srobo-legacy/boards-power-v4-hw/pbv4b_bom.xls

Line No. | Internal Part No. | Qty | Value/Description | Package | Distributor | Distributor Order No. | Manufacturer | Part No. | Reference Designators
1 | sr-c-100n-0402-16v | 35 | 100n capacitor 0402 16V X7R | 0402 | farnell | 1758896 | any/open |  | C4, C5, C8, C12, C15, C17, C24, C25, C27, C28, C29, C31, C32, C33, C34, C35, C37, C38, C39, C40, C41, C43, C44, C47, C48, C49, C50, C51, C52, C54, C56, C57, C58, C62, C63
2 | sr-c-100n-0603-50v | 2 | 100n capacitor 0603 50V X7R | 0603 | farnell | 1759122 | any/open |  | C1, C59
3 | sr-c-10n-0402-25v | 3 | 10n capacitor 0402 25V X7R | 0402 | farnell | 1758924 | any/open |  | C22, C45, C46
4 | sr-c-10p-0402-50v | 1 | 10p capacitor 0402 50V C0G/NP0 | 0402 | farnell | 1856064 | any/open |  | C19
5 | sr-c-10u-1206-16v | 8 | 10u capacitor 1206 16V X7R | 1206 | farnell | 2070502 | any/open |  | C3, C7, C13, C14, C26, C30, C36, C42
6 | sr-c-1u-0402-10v | 3 | 1u capacitor 0402 10V X5R | 0402 | farnell | 1759381 | any/open |  | C6, C23, C55
7 | sr-c-22u-0805-10v | 7 | 22u capacitor 0805 10V X5R | 0805 | farnell | 1867956 | any/open |  | C9, C10, C16, C18, C20, C21, C53
8 | sr-c-27p-0402-50v | 2 | 27p capacitor 0402 50V C0G/NP0 | 0402 | farnell | 1414584 | any/open |  | C60, C61
9 | sr-c-ucw1e471mnl1gs | 1 | 470u capacitor smt electrolytic 25V 850mA ripple | smt_electrolytic_cap | farnell | 1580575 | nichicon | UCW1E471MNL1GS | C2
10 | sr-cn-7460305 | 3 | M5 bushing 8 pin 2 row | press_fit | wurth | 7460305 | wurth elektronik | 7460305 | J1, J2, J3
11 | sr-cn-camcon2w | 6 | Pluggable terminal block 2way 7.5mm pitch male horiz | through_hole | farnell | 3882391 | camdenboss | CTB9550/2 | J8, J9, J10, J11, J12, J13
12 | sr-cn-camcon2w-5mm | 1 | Pluggable terminal block 2way 5mm pitch male horiz | through_hole | farnell | 3882093 | camdenboss | CTB9350/2A | J4
13 | sr-cn-header2x5-1.27mm | 1 | 2x5 through-hole 1.27mm header 3mm pin length | through_hole | farnell | 1577743 | any/open |  | J17
14 | sr-cn-header6 | 1 | 6Way header 1 row header | tht | farnell | 1593415 | any/open |  | J14
15 | sr-cn-minicamcon2w | 3 | Pluggable terminal block 2way 3.81mm pitch male horiz | through_hole | farnell | 1717071 | camdenboss | CTB93HE/2 | J6, J7, J15
16 | sr-cn-usb-micro-b | 1 | Micro USB B connector for top mounting | through_hole | digikey | 609-4048-6-ND | fci | 10103592-0001LF | J16
17 | sr-d-bat754c | 1 | schottky diode dual | sot23 | farnell | 1081205 | nxp | BAT754C | D13
18 | sr-d-bzx384c3v3 | 1 | zener diode 3.3V 5% | sod323 | farnell | 8735646 | nxp | BZX384-C3V3 | D4
19 | sr-d-mmbz15val | 3 | 12V unidirectional dual TVS diode 40W common anode | sot23 | farnell | 1829193 | nxp | MMBZ15VAL | D3, D14, D15
20 | sr-d-mmsz4689t1g | 1 | zener diode 5.1V 500mW | sod123 | farnell | 1459121 | on semiconductor | MMSZ4689T1G | D6
21 | sr-d-pesd5z12 | 9 | 12V unidirectional TVS diode 200W | sod523 | farnell | 1829227 | nxp | PESD5Z12 | D2, D7, D8, D9, D10, D11, D12, D16, D17
22 | sr-d-smaj15ca | 1 | 15V bidirectional TVS diode 400W | do-214ac(sma) | farnell | 9802789 | stmicroelectronics | SMAJ15CA-TR | D1
23 | sr-d-smaj5.0a | 1 | 5V unidirectional TVS diode 400W | do-214ac(sma) | farnell | 1815679 | vishay | SMAJ5.0A-E3/5A | D5
24 | sr-fan-40-10-12v | 1 | 40mmx40mmx10mm axial fan 12V | wire_ended | farnell | 1924856 | any/open |  | X2
25 | sr-fb-200m-1k-0402 | 1 | 200mA 1k @ 100MHz 0402 | 0402 | farnell | 1669673 | tdk | MMZ1005Y102C | L3
26 | sr-fet-n-bsh121 | 3 | BSH121 n-channel mosfet very low Vt of 1V | sot323 | farnell | 1758072 | nxp | BSH121 | Q3, Q4, Q5
27 | sr-fet-n-irfh5301 | 2 | IRFH5301PBF n-channel mosfet 35A | pqfn8 | farnell | 1782047 | international rectifier | IRFH5301TR2PBF | Q1, Q2
28 | sr-fuse-r125-1206 | 2 | 125mA 30V resettable fuse | 1206 | farnell | 1596988 | littelfuse | 1206L012WR | F2, F3
29 | sr-fuse-r1850-2920 | 1 | 1.85A 33V resettable fuse | 2920 | farnell | 1822228 | littelfuse | 2920L185DR | F4
30 | sr-ic-ina219 | 2 | INA219AIDCNR I2C current sense amp | sot23-8 | farnell | 2295989 | ti | INA219AIDCNR | U1, U4
31 | sr-ic-mcp9701at | 1 | Temperature sensor | sc70-5 | farnell | 1627203 | microchip | MCP9701AT-E/LT | U9
32 | sr-ic-stf202 | 1 | USB EMI/ESD protection and termination | sot23-6 | farnell | 1651958 | on semiconductor | STF202-22T1G | U11
33 | sr-ic-stm32f103r6 | 1 | STM32F103R6 32bit mcu 32k flash 10k ram | lqfp64 | farnell | 1899014 | stmicroelectronics | STM32F103R6T6A | U10
34 | sr-ic-tps54327drc | 1 | TPS54327DRC step-down DC/DC converter synchronous 18V 3A | son10 | farnell | 2361237 | ti | TPS54327DRCT | U3
35 | sr-ic-tps62125dsg | 1 | TPS62125DSG step-down DC/DC converter synchronous 17V 300mA | son8 | farnell | 2144287 | ti | TPS62125DSGT | U2
36 | sr-ic-vnd5012 | 4 | VND5012AK-E 12mR dual MOSFET | powersso-24 | rs | 445-781 | stmicroelectronics | VND5012AK-E | U5, U6, U7, U8
37 | sr-l-22u-380ma | 1 | 22u 380mA smt inductor | smt_inductor | farnell | 2292500 | laird technologies | TYS252012L220M-10 | L1
38 | sr-l-3u3-3000ma | 1 | 3.3u inductor 3A | smt_inductor | farnell | 2145279 | coiltronics | MPI4040R3-3R3-R | L2
39 | sr-led-green-0805 | 1 | LED 0805 Green | 0805 | farnell | 1318243 | kingbright | KP-2012SGC | DS2
40 | sr-led-redgreen-0805 | 8 | Dual LED Red/Green | 0805_split | farnell | 1686079 | kingbright | KPHBM-2012SURKCGKC | DS1, DS3, DS4, DS5, DS6, DS7, DS8, DS9
41 | sr-piezo-pkm13epy-4000-a0 | 1 | THT 12.6mm piezo sounder | tht | farnell | 1192513 | murata | PKM13EPY-4000-A0 | X1
42 | sr-r-10-0402 | 4 | 10 0402 chip resistor 1% | 0402 | farnell | 2072541 | any/open |  | R3, R4, R17, R18
43 | sr-r-100-0402 | 11 | 100 0402 chip resistor (63mW) 1% | 0402 | farnell | 2072515 | any/open |  | R10, R63, R65, R66, R67, R68, R69, R70, R71, R72, R73
44 | sr-r-1000k-0402 | 1 | 1M 0402 chip resistor 1% | 0402 | farnell | 2072521 | any/open |  | R58
45 | sr-r-10k-0402 | 22 | 10k 0402 chip resistor 1% | 0402 | farnell | 2072517 | any/open |  | R5, R6, R15, R16, R22, R23, R25, R29, R30, R32, R36, R37, R42, R43, R47, R53, R54, R56, R59, R62, R64, R74
46 | sr-r-10m-0805 | 1 | 10m 0805 chip resistor | 0805 | farnell | 8067643 | any/open |  | R14
47 | sr-r-150k-0402 | 1 | 150k 0402 chip resistor 1% | 0402 | farnell | 2072648 | any/open |  | R20
48 | sr-r-180k-0402 | 1 | 180k 0402 chip resistor 1% | 0402 | farnell | 2072711 | any/open |  | R9
49 | sr-r-1k-0402 | 6 | 1k 0402 chip resistor 1% | 0402 | farnell | 2072516 | any/open |  | R48, R49, R50, R60, R61, R75
50 | sr-r-1k-0805 | 6 | 1k 0805 chip resistor 1% | 0805 | farnell | 2073606 | any/open |  | R21, R28, R35, R38, R41, R46
51 | sr-r-1m-2512-1w | 2 | 1m 2512 1W 50ppm | 2512 | farnell | 1292474 | welwyn | ULR1-R001FT2 | R1, R2
52 | sr-r-200-0402 | 1 | 200 0402 chip resistor 1% | 0402 | farnell | 2072751 | any/open |  | R19
53 | sr-r-3k3-0402 | 6 | 3k3 0402 chip resistor 1% | 0402 | farnell | 2072928 | any/open |  | R26, R27, R33, R34, R39, R40
54 | sr-r-4700k-0402 | 1 | 4.7M 0402 chip resistor 1% | 0402 | farnell | 2141492 | any/open |  | R7
55 | sr-r-4k7-0402 | 5 | 4k7 0402 chip resistor 1% | 0402 | farnell | 2073064 | any/open |  | R24, R31, R52, R55, R57
56 | sr-r-560-0402 | 2 | 560 0402 chip resistor 1% | 0402 | farnell | 2073129 | any/open |  | R44, R45
57 | sr-r-576k-0402 | 1 | 576k 0402 chip resistor 1% | 0402 | farnell | 2073149 | any/open |  | R8
58 | sr-r-57k6-0402 | 2 | 57.6k 0402 chip resistor 1% | 0402 | farnell | 2073148 | any/open |  | R12, R13
59 | sr-r-64k9-0402 | 1 | 64.9k 0402 chip resisotr 1% | 0402 | farnell | 2073190 | any/open |  | R11
60 | sr-r-680-1206 | 1 | 680 1206 chip resistor (0.5W) | 1206 | farnell | 1739010 | any/open |  | R51
61 | sr-ra-4-10k-0402 | 2 | 4pack of 10k resistors 0804 (0402 equiv) | 0804_res_arr | farnell | 1770152 | bourns | CAY10-103J4LF | RN1, RN3
62 | sr-ra-4-4k7-0402 | 1 | 4pack of 4k7 resistors 0804 (0402 equiv) | 0804_res_arr | farnell | 1770151 | bourns | CAY10-472J4LF | RN2
63 | sr-sw-spph410100 | 1 | DPST vertical latching push button | tht | farnell | 1435768 | alps | SPPH410100 | S1
64 | sr-sw-spph410200 | 1 | DPST vertical non-latching push button | tht | farnell | 1435769 | alps | SPPH410200 | S2
65 | sr-xtal-abmm2-8.000mhz-e2-t | 1 | 8MHz Crystal 20ppm | smt_crystal | farnell | 1611803 | abracon | ABMM2-8.000MHZ-E2-T | Y1
