srobo-legacy/boards-power-v4-hw/case_testpoint.dxf

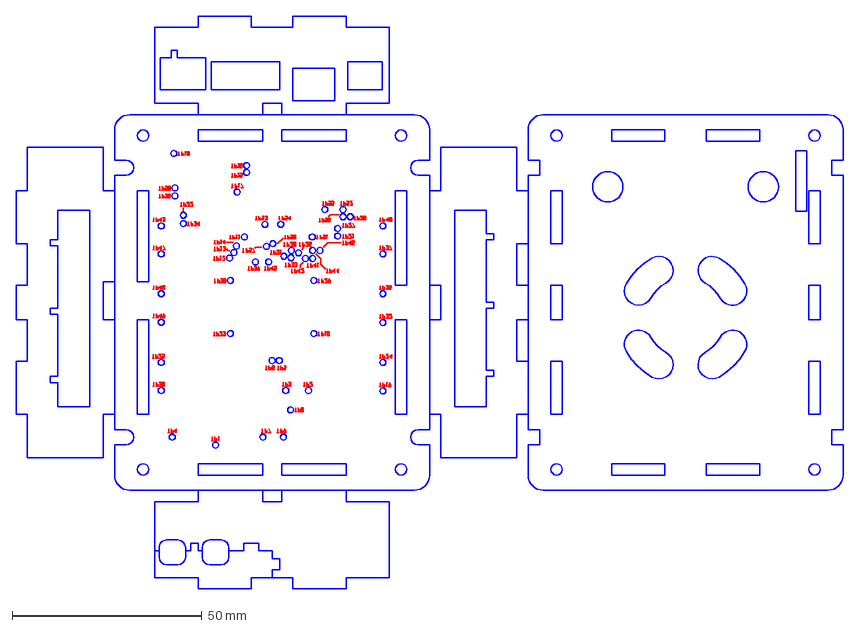
[picture p1: CAD file, 2014-02-19]
case_testpoint.dxf
218.0 x 151.0 mm
