srobo-legacy/boards-power-v4-hw/(list of files, drawings)

Other design files:
pcb_silk/labels_back.pcb
pcb_silk/labels_front.pcb
power.pcb
prototype_1/prototype_1.pcb
