srobo-legacy/boards-power-v4-hw/(commit log)

2013-11-30 Add .gitignore
    Copied from motor-v4-hw.git. I'm also doing this as git won't let me add
    submodules unless I've made at least one commit.
2013-12-02 Add config files for prototype 1 design
2013-12-02 Add first prototype design
    This is to verify the thermal viability of using the ST VND5012AK dual
    high-side driver IC. It is also a test of the Wurth push-fit connectors.
    [prototype_1.pcb, prototype_1.sch]
2013-12-02 Add gerbers for prototype 1
    [sr_pbv4_prototype_1.bottom.gbr, sr_pbv4_prototype_1.top.gbr]
2013-12-03 Add another test push-fit connector to prototype 1
    This allows for another hole size to be tested.
    The design now has the following hole sizes specified:
    1.45mm, 1.50mm, 1.55mm and 1.60mm.
    Hopefully one of these will result in PCB Train using a 1.6mm drill bit.
    [prototype_1.pcb, prototype_1.sch]
2013-12-03 Update prototype 1 gerbers
    [sr_pbv4_prototype_1.bottom.gbr, sr_pbv4_prototype_1.top.gbr]
2013-12-03 Add an outline to prototype 1
    [prototype_1.pcb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]
2013-12-23 Add some thermal data collected from the prototype
    [cased_power_prototype_18_fan.csv, cased_power_prototype_18_fan_soldered.csv, cased_power_prototype_18_nofan.csv, cased_power_prototype_31_fan_fullspeed_soldered.csv, cased_power_prototype_31_fan_soldered.csv]
2013-12-23 Add gaf/pcb config files
2013-12-26 Add schematic title page with block diagram
    [power-title.sch]
2013-12-27 Add blank schematic pages
    [power-1-title.sch, power-2-battery.sch, power-3-supply.sch, power-4-output.sch, power-5-control.sch]
2013-12-29 Draw the 'battery' page of the schematic
    [power-2-battery.sch]
2013-12-29 Add test points to battery page
    Also add another decoupling cap to the current monitor
    [power-2-battery.sch]
2013-12-30 Draw the supply page of the schematic
    [power-2-battery.sch, power-3-supply.sch]
2013-12-30 Remove underscores from net names
    These aren't very readable when the name is placed directly on a net, as
    the underscore merges with the net itself.
    Also add a TVS diode to the external power switch terminal.
    [power-2-battery.sch, power-3-supply.sch]
2013-12-30 Various additions to supply page
    * Add pull-ups to 5V5 rail/output enable lines. This ensures that the
    BeagleBone will remain powered during a firmware upgrde of the power
    board.
    * Add zener to the 3V3 rail
    * Add potential dividers to 5V5 outputs for monitoring
    [power-3-supply.sch]
2013-12-30 Remove switch from 5V outputs
    Replace it with an INA219 current monitor. We don't need that much
    control over the 5V outputs and it is possible to turn the 5V regulator
    off anyway. The INA219 is cheap and allows us to monitor the current
    draw on the 5V rail.
    [power-3-supply.sch]
2013-12-31 Draw the output page of the schematic
    [power-4-output.sch]
2014-01-04 Perform more thermal testing on the prototype
    This was carried out using a 40mm fan mounted in a cardboard lid.
    [card_18_fan_soldered.csv, card_18_fan_soldered_2.csv, card_18_fan_underside.csv, card_18_nofan_soldered.csv, card_31_fan9_underside.csv, card_31_fan_soldered.csv, card_31_fan_underside.csv]
2014-01-06 Draw the control page of the schematic
    [power-4-output.sch, power-5-control.sch]
2014-01-06 Add external temperature sensor
    [power-3-supply.sch, power-5-control.sch]
2014-01-07 Rearrange uC pin assignment for robustness
    Lots of the pins on the uC are '5V tolerant'. What this actually means
    is that they don't have any clamping diodes to the positive rail and are
    therefore more fragile; they cannot handle any injected current. I've
    rearranged the IO assignment so that almost all of the outputs are on
    the 5V tolerant pins and inputs that require clamping are on non-5V
    tolerant pins. The enable lines to the output switches do not require
    clamping diodes, as the discrete pull-down resistor effectively forms a
    potential divider looking into the uC. The only place which requires
    external clamping diodes is the UART data lines.
    [power-5-control.sch]
2014-01-07 Add test points
    [power-3-supply.sch, power-4-output.sch, power-5-control.sch]
2014-01-09 Replace dual TVS diodes with single TVS diodes
    These were more placeholders until I could be bothered to make the
    single TVS diode symbol.
    [power-2-battery.sch, power-3-supply.sch, power-4-output.sch, power-5-control.sch]
2014-01-09 Connect 5VEN to uC and add 5VTRIM line
    The 5VTRIM line will allow the uC to slightly reduce/boost the 5V output
    by either pulling the line high or low respectively. If it's left
    floating it'll have little to no effect on the output voltage.
    [power-3-supply.sch, power-5-control.sch]
2014-01-11 Shuffle uC pins around
    This puts all of the CSDIS lines next to each other on the IC to ease
    routing.
    [power-5-control.sch]
2014-01-11 Replace some resistors with resistor arrays
    [power-4-output.sch]
2014-01-12 Add quiescent currents to block diagram
    [power-1-title.sch]
2014-01-12 Update UVLO run time based upon empirical data
    I have revised this estimate after performing some discharge tests on
    the batteries that we provide in the kit.
    [power-1-title.sch]
2014-01-13 Rearchitect power switch
    The power switch now only switches power to the 3V3 SMPS and UVLO. The
    added quiescent current from the 5V SMPS when the board is switched off
    is negligible. This massively reduces the amount of current flowing
    through the power switch.
    Also move the fan and its FET onto the supply schematic page.
    [power-1-title.sch, power-2-battery.sch, power-3-supply.sch, power-5-control.sch]
2014-01-13 Swap output LEDs for dual green/red LEDs
    [power-4-output.sch, power-5-control.sch]
2014-01-13 Make status LEDs active low
    This helps to balance the current through the uC supply pins as it has a
    maximum of 150mA for Vcc/GND.
    [power-5-control.sch]
2014-01-13 Move LEDs further down on the page
    No electrical change
    [power-5-control.sch]
2014-01-13 Assign reference designators
    [power-2-battery.sch, power-3-supply.sch, power-4-output.sch, power-5-control.sch]
2014-01-14 Add values to battery page components
    Also remove unnecessary TVS diodes from current sense lines. The VBATT
    line is already protected by the big TVS diode.
    [power-2-battery.sch]
2014-01-16 Add some component values to the supply page
    [power-3-supply.sch]
2014-01-16 Change the 3.3V SMPS and UVLO solution
    The previous solution used the same SMPS IC as the 5V rail, which was
    good in terms of reusing the same part, but suboptimal due to it being
    designed for large currents (~3A). It also required a separate IC to
    perform the UVLO functionality, which was quite expensive.
    This solution uses a single IC that is much more suited to low current
    draw (it is very efficient down to essentially 0A) and has a built in
    micro-power comparator which can be used for UVLO. It's also a much
    cheaper solution.
    [power-3-supply.sch]
2014-01-16 Add cap to 3.3V SMPS enable line
    This forms a low-pass filter with the enable resistors, having a time
    constant of 56ms. This prevents false triggering of the UVLO when large
    capacitances (read: motor boards) are switched on.
    [power-3-supply.sch]
2014-01-16 Fix copy/paste error on the output page
    Thanks to Alistair for spotting this.
    [power-4-output.sch]
2014-01-16 Update block diagram and add notes about UVLO
    [power-1-title.sch, power-3-supply.sch]
2014-01-17 Add a load more values to the supply page
    [power-3-supply.sch]
2014-01-18 Assign values to more components on the output page
    [power-4-output.sch]
2014-01-18 Assign values to most components on the control page
    [power-2-battery.sch, power-3-supply.sch, power-5-control.sch]
2014-01-18 Set value of all test points to sr-nothing
    [power-2-battery.sch, power-3-supply.sch, power-4-output.sch, power-5-control.sch]
2014-01-19 Assign the last few component values
    [power-2-battery.sch, power-3-supply.sch, power-4-output.sch, power-5-control.sch]
2014-01-19 Add a couple more caps and renumber all refdeses
    [power-2-battery.sch, power-3-supply.sch, power-4-output.sch, power-5-control.sch]
2014-01-19 Hack around slotting across pages
    [power-5-control.sch]
2014-01-19 Add a more quiescent discharge detail
    [power-1-title.sch]
2014-01-19 Shift flat LED to a different uC pin
    This was on the BOOT1 pin and the LED was wired up to be active low.
    This would have had the effect of pulling the BOOT1 pin high all of the
    time, therefore making it impossible to enter the ROM bootloader.
    [power-5-control.sch]
2014-01-19 Ignore BOM html file
2014-01-19 Add notes next to all connectors
    [power-2-battery.sch, power-3-supply.sch, power-4-output.sch, power-5-control.sch]
2014-01-19 Alter some uncommon parts for more common ones
    The values of these components aren't that critical, so it's better to
    select a value that's already being used on the board to reduce the
    number of BOM lines.
    [power-2-battery.sch, power-5-control.sch]
2014-01-19 Add footprint attributes to 0402 components
    [power-2-battery.sch, power-3-supply.sch, power-4-output.sch, power-5-control.sch]
2014-01-19 Assign 0603/0805/1206 footprints
    [power-2-battery.sch, power-3-supply.sch, power-4-output.sch, power-5-control.sch]
2014-01-19 Add SOT/SOD/DO footprints
    [power-2-battery.sch, power-3-supply.sch, power-5-control.sch]
2014-01-19 Add testpoint footprints
    [power-2-battery.sch, power-3-supply.sch, power-4-output.sch, power-5-control.sch]
2014-01-19 Add more footprints
    These are footprints I have confidence in without detailed checking.
    [power-2-battery.sch, power-3-supply.sch, power-4-output.sch, power-5-control.sch]
2014-01-21 Add more footprints
    [power-2-battery.sch, power-3-supply.sch, power-4-output.sch, power-5-control.sch]
2014-01-22 More footprints
    [power-3-supply.sch, power-4-output.sch, power-5-control.sch]
2014-01-23 Add fan footprint (to separate symbol)
    [power-3-supply.sch, power-5-control.sch]
2014-01-24 Add final footprints
    [power-3-supply.sch, power-5-control.sch]
2014-01-24 Add empty pcb layout with DRC/layers/routing configured
    [power.pcb]
2014-01-24 Import schematics into the PCB layout
    [power.pcb]
2014-01-24 Perform initial placement of big components
    [power.pcb]
2014-01-25 More placement + netname fix
    3V3 and VBATTSW got merged due to a typo on an io symbol
    [power-3-supply.sch, power.pcb]
2014-01-25 Remap resistor network element assignment
    [power-4-output.sch, power.pcb]
2014-01-25 Placement + netname fix
    [power-5-control.sch, power.pcb]
2014-01-25 Placement + resistor array remapping
    [power-4-output.sch, power.pcb]
2014-01-26 Shuffle some components
    [power.pcb]
2014-01-26 Reduce size of layout canvas
    [power.pcb]
2014-01-29 Change power and start buttons for push buttons
    The others were small and fiddly. These are manly beasts.
    [power-3-supply.sch, power-5-control.sch]
2014-01-30 Swap switch/button symbols for DPDT
    The power switch and start button that I want to use are DPDT switches,
    although we don't actually need that.
    [power-3-supply.sch, power-5-control.sch]
2014-01-31 Swap power switch and start button on layout to push buttons
    [power.pcb]
2014-02-01 Connect second power switch pole to microcontroller
    There is the slight possibility that the board might not power down when
    the power switch is turned off. This could happen if somehow current was
    being injected into the 3.3V rail from either a 12V output or the 5V
    output. It should be impossible as the only place where current could be
    injected is the external start button connector and this has a 4k7
    resistor in series, limiting the current to 2mA max. The power LED on
    the 3.3V rail draws way more current than this.
    However, the second pole of the power switch is available and connecting
    it to the microcontroller is free. It will allow the microcontroller to
    read the state of the interna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
    [power-3-supply.sch, power-5-control.sch, power.pcb]
2014-02-05 Fix DRC errors
    [power.pcb]
2014-02-05 Routing complete!
    [power.pcb]
2014-02-06 Tidy up layout planes
    [power.pcb]
2014-02-06 Update fan footprint with 3mm mounting holes
    [power.pcb]
2014-02-09 Position reference designators on layout
    [power.pcb]
2014-02-09 Shuffle some passives to increase pad clearance
    There was a pad that was too close to some silk
    [power.pcb]
2014-02-09 Assign ref des to fan
    [power-3-supply.sch, power.pcb]
2014-02-09 Increase clearance around piezo pins
    [power.pcb]
2014-02-09 Add connector/LED labels to top silk
    [labels.pcb, power.pcb]
2014-02-10 Add fancy back silk
    [labels_back.pcb, labels_front.pcb, power.pcb]
2014-02-10 Shuffle some test point labels around
    They were right under where a screw head is going to sit once the fan is
    bolted on.
    Also PCB has decided to make a load of other changes for no apparent
    reason.
    [power.pcb]
2014-02-11 Final tweaks to traces and more ground stitching vias
    [power.pcb]
2014-02-11 Add Rev A gerbers
    [pbv4a.bottom.gbr, pbv4a.bottommask.gbr, pbv4a.bottomsilk.gbr, pbv4a.fab.gbr, pbv4a.inner1.gbr, pbv4a.inner2.gbr, pbv4a.outline.gbr, pbv4a.top.gbr]
2014-02-13 Add beginnings of the case design
    [case.dxf]
2014-02-16 Change 100mA polyfuses to 125mA polyfuses
    The 100mA polyfuses were actually in 1210 packages rather than 1206. The
    only 1206 100mA polyfuses on Farnell are quite expensive, so I've just
    gone for a cheaper 125mA one instead.
    [power-3-supply.sch]
2014-02-17 Finish case design
    [case.dxf]
2014-02-18 Increase size of ring terminal holes in case
    [case.dxf]
2014-02-18 Add mounting notches to case
    [case.dxf]
2014-02-18 Remove double line from case design
    [case.dxf]
2014-02-19 Realign board outline in case drawing
    This wasn't moved when I added in the extra bit of width for the
    mounting notches
    [case.dxf]
2014-02-19 Add case design with testpoint holes in the base
    [case_testpoint.dxf]
2014-06-20 Add case sticker design
2014-06-29 Fix font name in case sticker design
    The bold flavour of Eurostile comes as a separate font called
    'Eurostile-Bold'
2014-06-29 Move sticker cutline onto separate layer
    Also add bleed around button hole cutouts
2014-06-30 Resave case with LibreCAD 2.0.4
    There should be no difference in the design, but it's shuffled a load of
    things around in the file.
    [case.dxf]
2014-06-30 Reduce size of case button holes
    They're now 7.6mm in diameter, giving 0.1mm clearance around the button.
    [case.dxf]
2014-06-30 Tweak case sticker cut-lines
    Increase the space around the UART header and reduce the size of the
    cut-outs around the buttons.
2014-07-12 Add polarity indication and name to case sticker
2014-07-12 Actually add board name to the case sticker
2014-07-12 Add mechanical component schematic sheet
    [power-1-title.sch, power-2-battery.sch, power-3-supply.sch, power-4-output.sch, power-5-control.sch, power-6-mechanical.sch]
2014-07-12 Add case, cable and button components
    [power-6-mechanical.sch]
2014-07-13 Add case, case sticker and fuse components to schematic
    [power-2-battery.sch, power-6-mechanical.sch]
2014-07-13 Assign refdeses to mechanical components
    [power-6-mechanical.sch]
2014-07-13 Increase copper clearance around positive battery terminal
    These terminals are push-fit and are just blocks of metal. There's very
    little to prevent them from shorting to copper directly underneath. The
    terminal is slightly raised in the middle, but could short to the top
    copper layer around the pins. Increase the clearance to the copper
    around pins of the positive battery terminal.
    [power.pcb]
2014-07-13 Add pull-down to fan control line
    [power-3-supply.sch, power.pcb]
2014-07-13 Pull-down 5V enable line
    The original idea was that the 5V rail would be enabled by the 3V3 rail
    and optionally disabled by the micro. What actually happens is that the
    5V rail blips on when the board is turned off. It's just must safer to
    have a pull-down on the enable line and let the micro turn the 5V rail
    on. The only downside to this is that, when the micro is rebooted after
    performing a firmware upgrade, we need the 5V rail to remain up. This
    is achieved with a cap, which will hold the enable line high for a short
    period.
    [power-3-supply.sch, power.pcb]
2014-07-14 Alter size of case side panel bottom tabs
    One of them was a different size to the rest. As well as making sure
    they're all the size I expect I've also made the two tabs different
    sizes to make assembly easier/less error prone.
    [case.dxf]
2014-07-14 Correct start button plug tab cutout position
    [case.dxf]
2014-07-19 Reduce height of case by 2mm
    This allows the power and start buttons to protrude above the top of the
    case even when they're pressed. Unfortunately this now means that the
    camcon plugs will foul the top panel of the case. To prevent this there
    needs to be cut-outs above each 7.5mm and 5mm camcon socket.
    [case.dxf]
2014-07-19 Move case cable tie slots to not overlap buttons
    [case.dxf]
2014-09-02 Add pin 1 indication to silk
    [power.pcb]
2014-09-02 Change I2C pull ups to 1k
    There's no harm them being stronger
    [power-5-control.sch, power.pcb]
2014-09-02 Bump to Rev B
    [labels_back.pcb, power-1-title.sch, power-2-battery.sch, power-3-supply.sch, power-4-output.sch, power-5-control.sch, power-6-mechanical.sch, power.pcb]
2014-09-02 Add Rev B gerbers
    [pbv4a.fab.gbr, pbv4b.assembly.gbr, pbv4b.bottom.gbr, pbv4b.bottommask.gbr, pbv4b.bottomsilk.gbr, pbv4b.group2.gbr, pbv4b.group3.gbr, pbv4b.outline.gbr]
2014-09-02 Add board manufacture/assembly readme
2014-09-02 Add assembly house compatible BOM
    [pbv4b_bom.xls]
2014-09-09 Add countersink specification to case drawing
    [case.dxf]
2014-09-09 Clear the RTS line before trying to flash a board
    The RTS line is connected to the BOOT0 line of the micro so controls if
    it boots up into the ROM bootloader.
2014-09-09 Add pbv4_test binary
    Based on boards/power-v4-fw.git@e674340350824378e55a01e03d4b7c60d5f03cea
2014-09-09 Amend current values in test instructions
2014-10-08 Change case standoffs to 18mm
    Annoyingly I didn't update the schematic with the correct length hex
    standoffs after modifying the case design. I will have to return the 332
    20mmn standoffs that we bought :(
    [power-6-mechanical.sch]
